michael201110/cryobelt/cryobelt.kicad_pcb

## KiCad design cryobelt.kicad_pcb (2026-08-23)

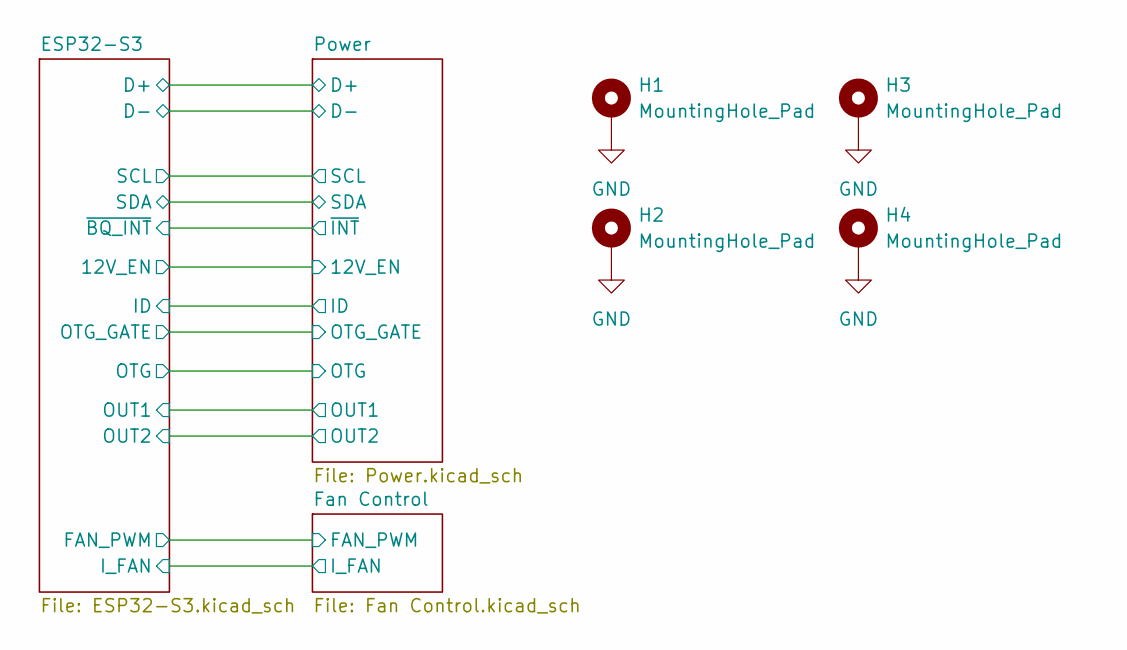
[picture p1: schematic cryobelt.kicad_sch]

Parts:
H1, H2, H3, H4: MountingHole_Pad; MountingHole_2.2mm_M2_Pad_TopBottom

Connections:
GND: H1.1 (1_1), H2.1 (1_1), H3.1 (1_1), H4.1 (1_1); also elsewhere on the board

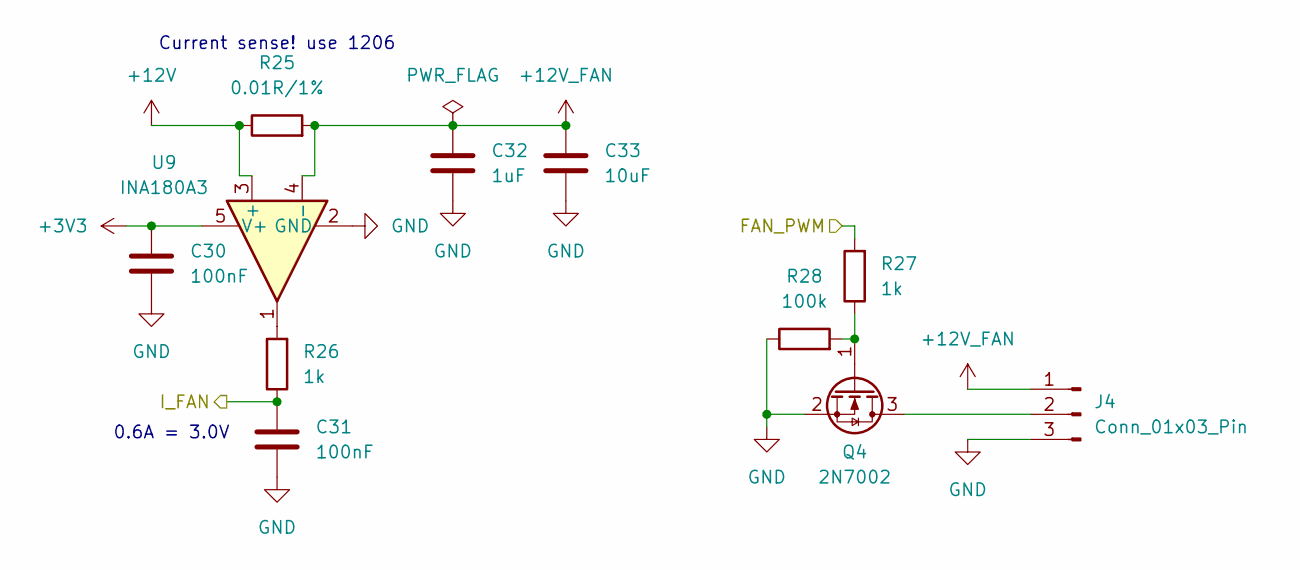
[picture p2: schematic Fan Control.kicad_sch]

Parts:
C30, C31: 100nF; C_0603_1608Metric; MPN CC0603KRX7R9BB104; LCSC Part # C14663
C32: 1uF; C_0603_1608Metric; MPN CL10A105KB8NNNC; LCSC Part # C15849
C33: 10uF; C_0603_1608Metric; MPN CL10A106MA8NRNC; LCSC Part # C96446
J4: Conn_01x03_Pin; JST_GH_SM03B-GHS-TB_1x03-1MP_P1.25mm_Horizontal; MPN SM03B-GHS-TB(LF)(SN); LCSC Part # C514175
Q4: 2N7002; SOT-23; MPN 2N7002; LCSC Part # C8545
R25: 0.01R/1%; R_1206_3216Metric; MPN FRM121WFR010TM; LCSC Part # C7467248
R26, R27: 1k; R_0603_1608Metric; MPN 0603WAF1001T5E; LCSC Part # C21190
R28: 100k; R_0603_1608Metric; MPN 0603WAF1003T5E; LCSC Part # C25803
U9: INA180A3; SOT-23-5; MPN INA180A3IDBVR; LCSC Part # C122882

Connections:
+3V3: C30.1, U9.5 (V+); also elsewhere on the board
+12V: R25.1, U9.3 (+); also elsewhere on the board
+12V_FAN: C32.1, C33.1, J4.1, R25.2, U9.4 (-)
/ESP32-S3/FAN_PWM: R27.2; also elsewhere on the board
/ESP32-S3/I_FAN: C31.1, R26.1; also elsewhere on the board
GND: C30.2, C31.2, C32.2, C33.2, J4.3, Q4.2 (S), R28.1, U9.2 (GND); also elsewhere on the board
unnamed: J4.2, Q4.3 (D)
unnamed: Q4.1 (G), R27.1, R28.2
unnamed: R26.2, U9.1

Notes on the sheet:
0.6A = 3.0V
Current sense! use 1206

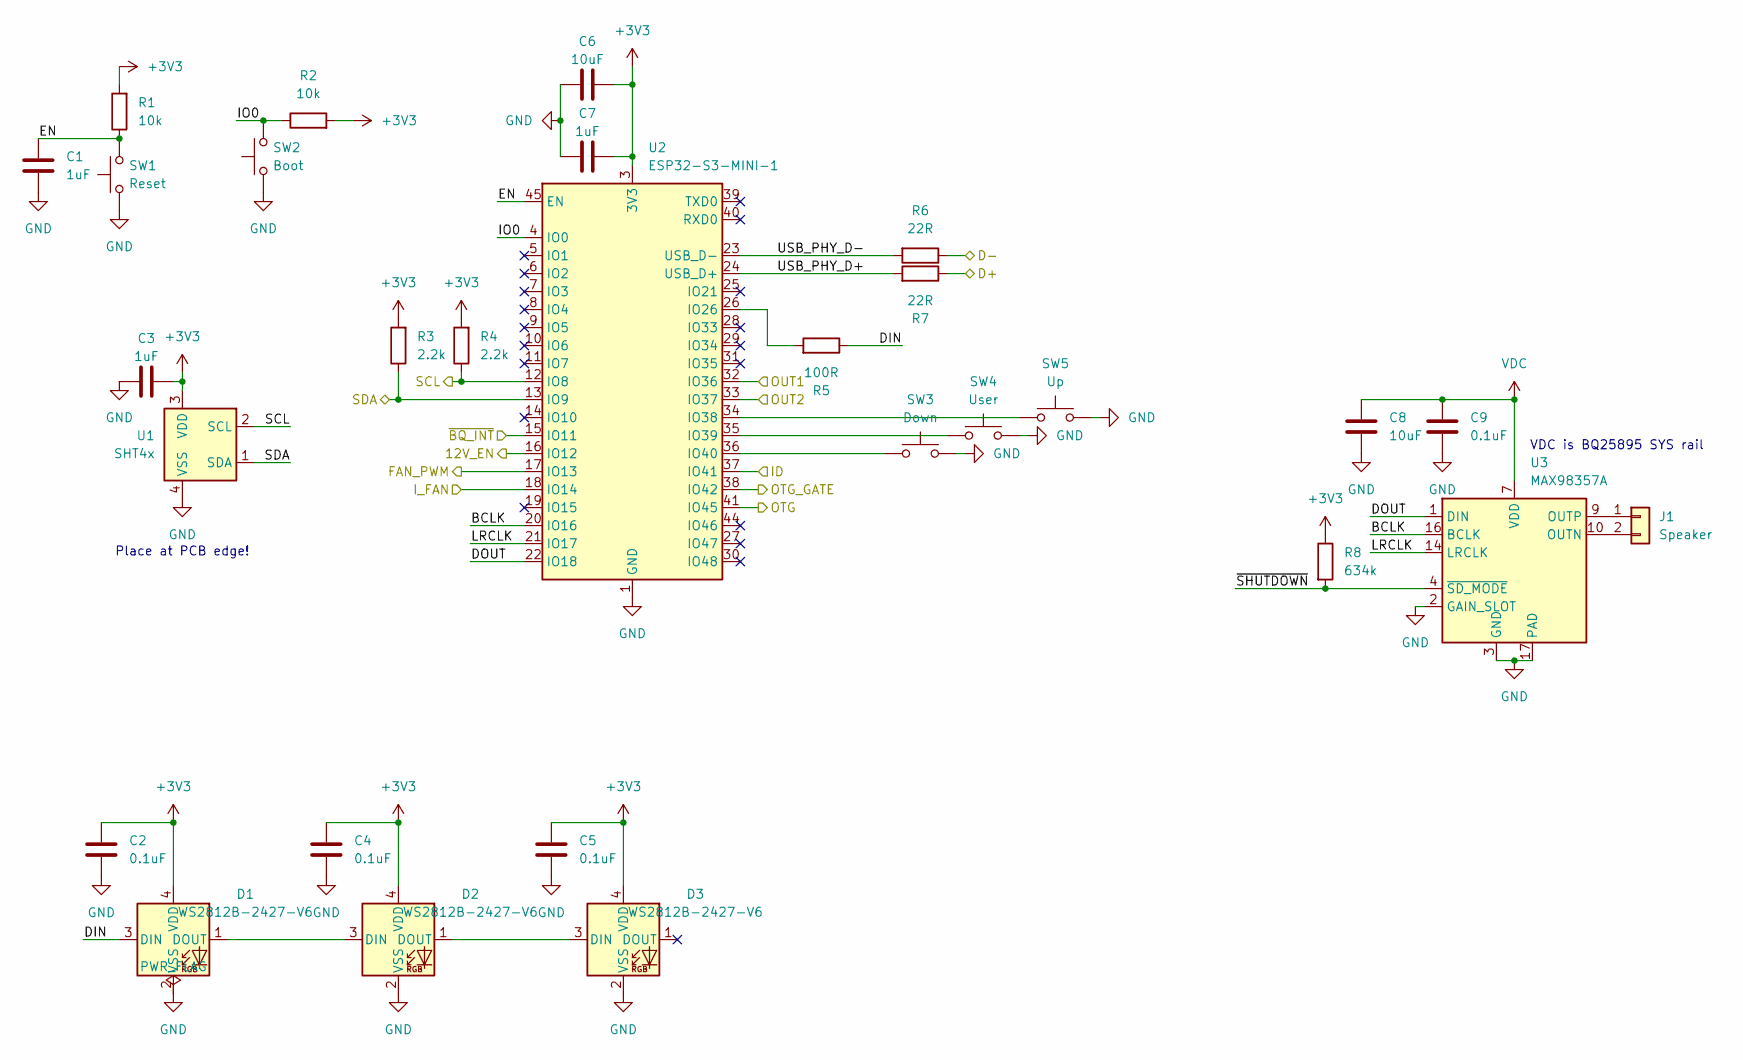
[picture p3: schematic ESP32-S3.kicad_sch]

Parts:
C1, C3, C7: 1uF; C_0603_1608Metric; MPN CL10A105KB8NNNC; LCSC Part # C15849
C2, C4, C5: 0.1uF; C_0402_1005Metric; MPN CL05B104KO5NNNC; LCSC Part # C1525
C6, C8: 10uF; C_0603_1608Metric; MPN CL10A106KP8NNNC; LCSC Part # C19702
C9: 0.1uF; C_0603_1608Metric; MPN CC0603KRX7R9BB104; LCSC Part # C14663
D1, D2, D3: WS2812B-2427-V6; WS2812B-2427-V6_Rotated180; MPN WS2812B-2427-V6; LCSC Part # C52941389
J1: Speaker; SolderWire-0.1sqmm_1x02_P3.6mm_D0.4mm_OD1mm
R1, R2: 10k; R_0603_1608Metric; MPN 0603WAF1002T5E; LCSC Part # C25804
R3, R4: 2.2k; R_0603_1608Metric; MPN 0603WAF2201T5E; LCSC Part # C4190
R5: 100R; R_0603_1608Metric; MPN 0603WAF1000T5E; LCSC Part # C22775
R6, R7: 22R; R_0603_1608Metric; MPN 0603WAF220JT5E; LCSC Part # C23345
R8: 634k; R_0603_1608Metric; MPN RC0603FR-07634KL; LCSC Part # C273753
SW1: Reset; SW_Push_1P1T_XKB_TS-1187A; MPN TS-1187A-B-A-B; LCSC Part # C318884
SW2: Boot; SW_Push_1P1T_XKB_TS-1187A; MPN TS-1187A-B-A-B; LCSC Part # C318884
SW3: Down; PG1316S
SW4: User; PG1316S
SW5: Up; PG1316S
U1: SHT4x; Sensirion_DFN-4_1.5x1.5mm_P0.8mm_SHT4x_NoCentralPad; MPN SHT40-AD1B-R2; LCSC Part # C2909890
U2: ESP32-S3-MINI-1; MPN ESP32-S3-MINI-1-N8; LCSC Part # C2913206
U3: MAX98357A; TQFN-16-1EP_3x3mm_P0.5mm_EP1.23x1.23mm; MPN MAX98357AETE+T; LCSC Part # C910544

Connections:
+3V3: C2.1, C3.2, C4.1, C5.1, C6.2, C7.2, D1.4 (VDD), D2.4 (VDD), D3.4 (VDD), R1.2, R2.2, R3.2, R4.2, R8.1, U1.3 (VDD), U2.3 (3V3); also elsewhere on the board
/ESP32-S3/12V_EN: U2.16 (IO12); also elsewhere on the board
/ESP32-S3/BCLK: U2.20 (IO16), U3.16 (BCLK)
/ESP32-S3/D+: R7.1; also elsewhere on the board
/ESP32-S3/D-: R6.1; also elsewhere on the board
/ESP32-S3/DIN: D1.3 (DIN), R5.1
/ESP32-S3/DOUT: U2.22 (IO18), U3.1 (DIN)
/ESP32-S3/EN: C1.1, R1.1, SW1.2, U2.45 (EN)
/ESP32-S3/FAN_PWM: U2.17 (IO13); also elsewhere on the board
/ESP32-S3/ID: U2.37 (IO41); also elsewhere on the board
/ESP32-S3/IO0: R2.1, SW2.2, U2.4 (IO0)
/ESP32-S3/I_FAN: U2.18 (IO14); also elsewhere on the board
/ESP32-S3/LRCLK: U2.21 (IO17), U3.14 (LRCLK)
/ESP32-S3/OTG: U2.41 (IO45); also elsewhere on the board
/ESP32-S3/OTG_GATE: U2.38 (IO42); also elsewhere on the board
/ESP32-S3/OUT1: U2.32 (IO36); also elsewhere on the board
/ESP32-S3/OUT2: U2.33 (IO37); also elsewhere on the board
/ESP32-S3/SCL: R4.1, U1.2 (SCL), U2.12 (IO8); also elsewhere on the board
/ESP32-S3/SDA: R3.1, U1.1 (SDA), U2.13 (IO9); also elsewhere on the board
/ESP32-S3/USB_PHY_D+: R7.2, U2.24 (USB_D+)
/ESP32-S3/USB_PHY_D-: R6.2, U2.23 (USB_D-)
/ESP32-S3/~BQ_INT: U2.15 (IO11); also elsewhere on the board
/ESP32-S3/~SHUTDOWN: R8.2, U3.4 (~SD_MODE)
GND: C1.2, C2.2, C3.1, C4.2, C5.2, C6.1, C7.1, C8.2, C9.2, D1.2 (VSS), D2.2 (VSS), D3.2 (VSS), SW1.1, SW2.1, SW3.2, SW4.2, SW5.2, U1.4 (VSS), U2.1 (GND), U2.2 (GND), U2.42 (GND), U2.43 (GND), U2.46 (GND), U2.47 (GND), U2.48 (GND), U2.49 (GND), U2.50 (GND), U2.51 (GND), U2.52 (GND), U2.53 (GND), U2.54 (GND), U2.55 (GND), U2.56 (GND), U2.57 (GND), U2.58 (GND), U2.59 (GND), U2.60 (GND), U2.61 (GND), U2.62 (GND), U2.63 (GND), U2.64 (GND), U2.65 (GND), U3.2 (GAIN_SLOT), U3.3 (GND), U3.11 (GND), U3.15 (GND), U3.17 (PAD); also elsewhere on the board
unnamed: D1.1 (DOUT), D2.3 (DIN)
unnamed: D2.1 (DOUT), D3.3 (DIN)
unnamed: J1.1, U3.9 (OUTP)
unnamed: J1.2, U3.10 (OUTN)
unnamed: R5.2, U2.26 (IO26)
unnamed: SW5.1, U2.34 (IO38)
unnamed: SW4.1, U2.35 (IO39)
unnamed: SW3.1, U2.36 (IO40)
VDC: C8.1, C9.1, U3.7 (VDD), U3.8 (VDD); also elsewhere on the board

Notes on the sheet:
VDC is BQ25895 SYS rail
Place at PCB edge!

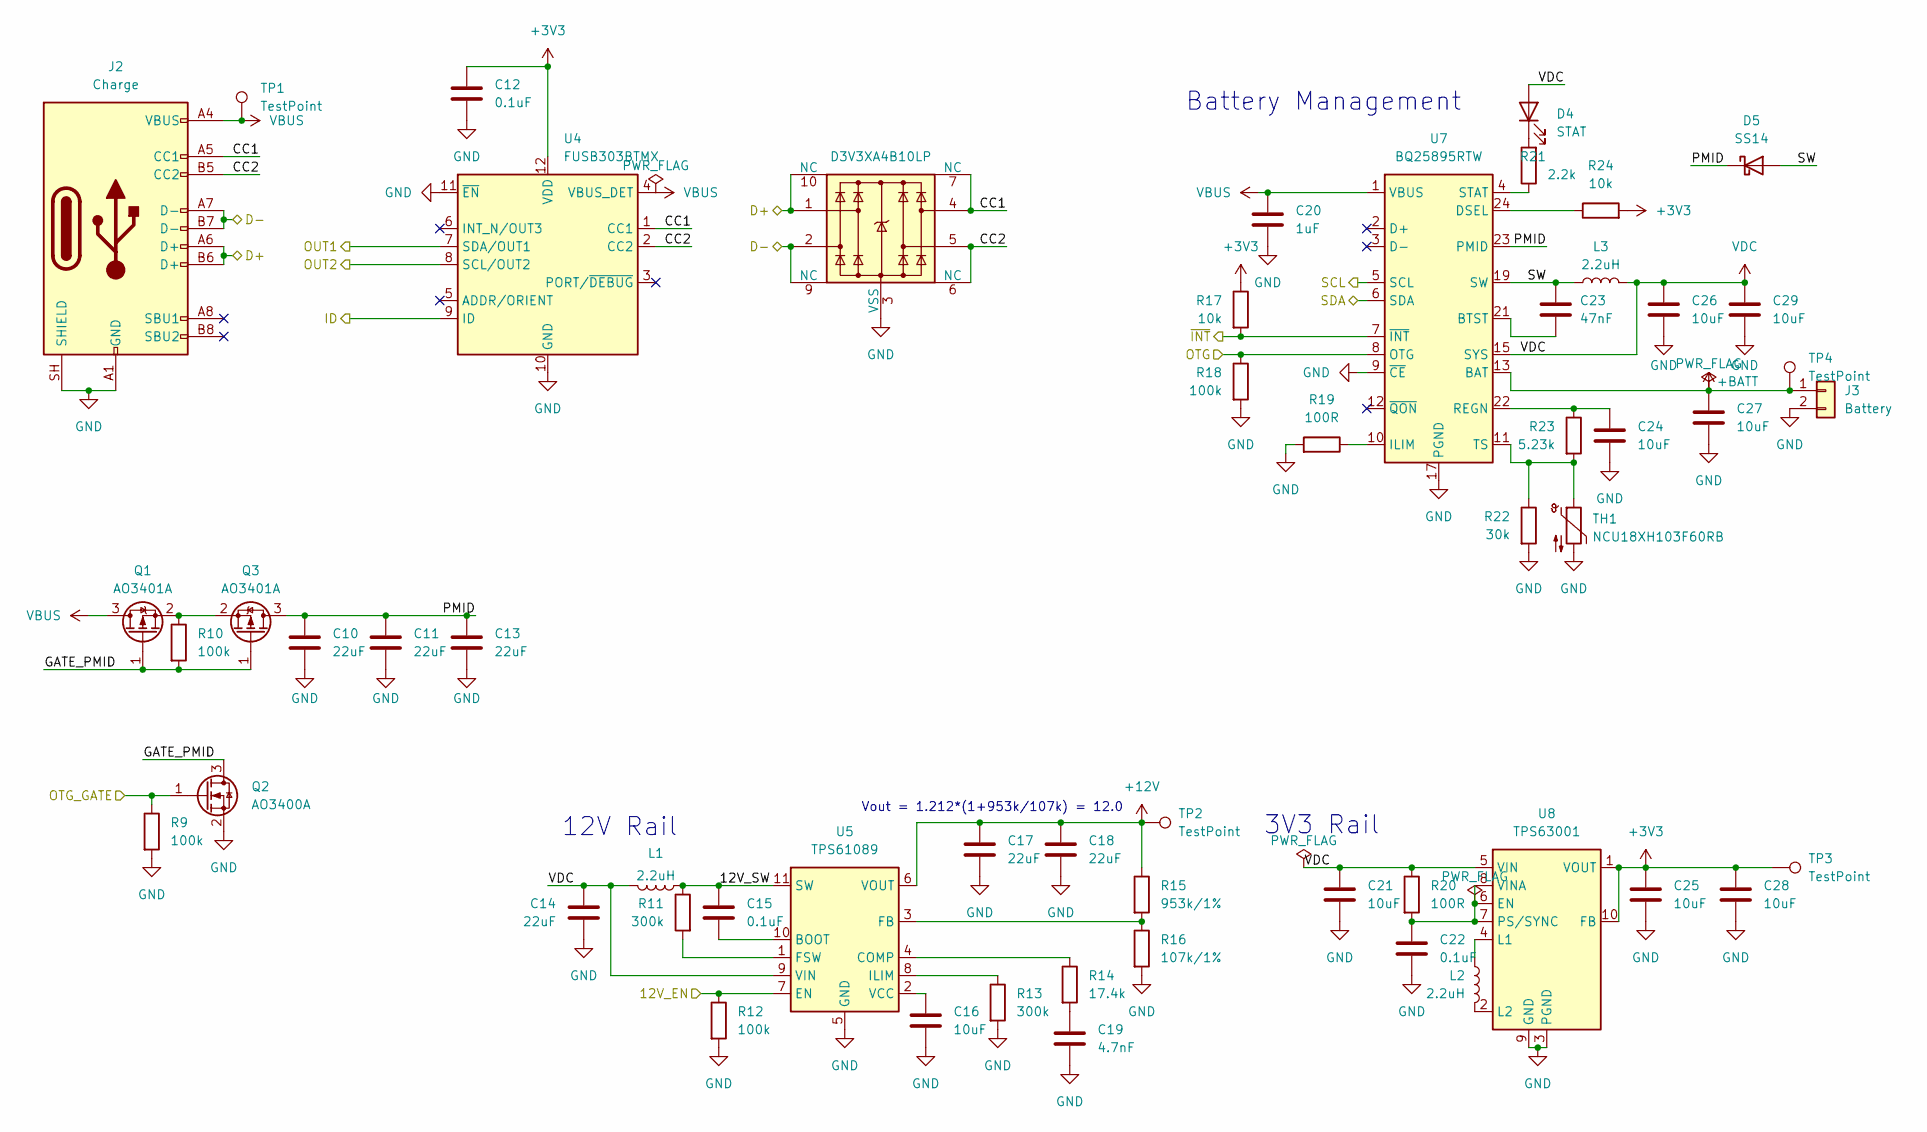
[picture p4: schematic Power.kicad_sch]

Parts:
C10, C11, C13, C17, C18: 22uF; C_0805_2012Metric; MPN CL21A226MAQNNNE; LCSC Part # C45783
C12, C15, C22: 0.1uF; C_0603_1608Metric; MPN CC0603KRX7R9BB104; LCSC Part # C14663
C14: 22uF; C_0603_1608Metric; MPN CL10A226MQ8NRNC; LCSC Part # C59461
C16, C21, C24, C25, C26, C27, C28, C29: 10uF; C_0603_1608Metric; MPN CL10A106KP8NNNC; LCSC Part # C19702
C19: 4.7nF; C_0603_1608Metric; MPN 0603B472K500NT; LCSC Part # C53987
C20: 1uF; C_0603_1608Metric; MPN CL10A105KB8NNNC; LCSC Part # C15849
C23: 47nF; C_0603_1608Metric; MPN CL10B473KB8NNNC; LCSC Part # C1622
D4: STAT; LED_0603_1608Metric; MPN KT-0603R; LCSC Part # C2286
D5: SS14; D_SMA; MPN SS14; LCSC Part # C2480
J2: Charge; USB_C_Receptacle_GCT_USB4110; MPN USB4110-GF-A; LCSC Part # C5143397
J3: Battery; JST_PH_S2B-PH-K_1x02_P2.00mm_Horizontal; MPN S2B-PH-K-S(LF)(SN); LCSC Part # C173752
L1, L2, L3: 2.2uH; L_Changjiang_FNR4030S; MPN FEXU0420S2R2MBS; LCSC Part # C54777963
Q1, Q3: AO3401A; SOT-23; MPN AO3401A; LCSC Part # C15127
Q2: AO3400A; SOT-23; MPN AO3400A; LCSC Part # C20917
R9, R10, R12, R18: 100k; R_0603_1608Metric; MPN 0603WAF1003T5E; LCSC Part # C25803
R11, R13: 300k; R_0603_1608Metric; MPN 0603WAF3003T5E; LCSC Part # C23024
R14: 17.4k; R_0603_1608Metric; MPN RC0603FR-0717K4L; LCSC Part # C185365
R15: 953k/1%; R_0603_1608Metric; MPN ERJ3EKF9533V; LCSC Part # C403405
R16: 107k/1%; R_0603_1608Metric; MPN RC0603FR-07107KL; LCSC Part # C245894
R17, R24: 10k; R_0603_1608Metric; MPN 0603WAF1002T5E; LCSC Part # C25804
R19, R20: 100R; R_0603_1608Metric; MPN 0603WAF1000T5E; LCSC Part # C22775
R21: 2.2k; R_0603_1608Metric; MPN 0603WAF2201T5E; LCSC Part # C4190
R22: 30k; R_0603_1608Metric; MPN 0603WAF3002T5E; LCSC Part # C22984
R23: 5.23k; R_0603_1608Metric; MPN RC0603FR-075K23L; LCSC Part # C185317
TH1: NCU18XH103F60RB; R_0603_1608Metric; MPN NCU18XH103F60RB; LCSC Part # C440252
TP1, TP2, TP3, TP4: TestPoint; TestPoint_Pad_D2.0mm
U4: FUSB303BTMX; Texas_X2QFN-12_1.6x1.6mm_P0.4mm; MPN FUSB303BTMX; LCSC Part # C895444
U5: TPS61089; Texas_VQFN-RNR0011A-11; MPN TPS61089RNRR; LCSC Part # C165129
U6: D3V3XA4B10LP; Diodes_UDFN-10_1x2.5mm_P0.5mm; MPN D3V3XA4B10LP-7; LCSC Part # C1980462
U7: BQ25895RTW; Texas_RTW_WQFN-24-1EP_4x4mm_P0.5mm_EP2.7x2.7mm_ThermalVias; MPN BQ25895RTWR; LCSC Part # C80200
U8: TPS63001; Texas_DRC0010J_ThermalVias; MPN TPS63001DRCR; LCSC Part # C28060

Connections:
+3V3: C12.1, C25.1, C28.1, R17.1, R24.2, TP3.1 (1_1), U4.12 (VDD), U8.1 (VOUT), U8.10 (FB); also elsewhere on the board
+12V: C17.1, C18.1, R15.1, TP2.1 (1_1), U5.6 (VOUT); also elsewhere on the board
+BATT: C27.1, J3.1, TP4.1 (1_1), U7.13 (BAT), U7.14 (BAT)
/ESP32-S3/12V_EN: R12.1, U5.7 (EN); also elsewhere on the board
/ESP32-S3/D+: J2.A6 (D+), J2.B6 (D+), U6.1, U6.10 (NC); also elsewhere on the board
/ESP32-S3/D-: J2.A7 (D-), J2.B7 (D-), U6.2, U6.9 (NC); also elsewhere on the board
/ESP32-S3/ID: U4.9 (ID); also elsewhere on the board
/ESP32-S3/OTG: R18.1, U7.8 (OTG); also elsewhere on the board
/ESP32-S3/OTG_GATE: Q2.1 (G), R9.1; also elsewhere on the board
/ESP32-S3/OUT1: U4.7 (SDA/OUT1); also elsewhere on the board
/ESP32-S3/OUT2: U4.8 (SCL/OUT2); also elsewhere on the board
/ESP32-S3/SCL: U7.5 (SCL); also elsewhere on the board
/ESP32-S3/SDA: U7.6 (SDA); also elsewhere on the board
/ESP32-S3/~BQ_INT: R17.2, U7.7 (~INT); also elsewhere on the board
/Power/12V_SW: C15.1, L1.2, R11.1, U5.11 (SW)
/Power/CC1: J2.A5 (CC1), U4.1 (CC1), U6.4, U6.7 (NC)
/Power/CC2: J2.B5 (CC2), U4.2 (CC2), U6.5, U6.6 (NC)
/Power/GATE_PMID: Q1.1 (G), Q2.3 (D), Q3.1 (G), R10.2
/Power/PMID: C10.1, C11.1, C13.1, D5.1 (K), Q3.3 (D), U7.23 (PMID)
/Power/SW: C23.1, D5.2 (A), L3.1, U7.19 (SW), U7.20 (SW)
GND: C10.2, C11.2, C12.2, C13.2, C14.2, C16.2, C17.2, C18.2, C19.2, C20.2, C21.2, C22.2, C24.2, C25.2, C26.2, C27.2, C28.2, C29.2, J2.A1 (GND), J2.A12 (GND), J2.B1 (GND), J2.B12 (GND), J2.SH (SHIELD), J3.2, Q2.2 (S), R9.2, R12.2, R13.2, R16.2, R18.2, R19.2, R22.2, TH1.2, U4.10 (GND), U4.11 (~EN), U5.5 (GND), U6.3 (VSS), U6.8 (VSS), U7.9 (~CE), U7.17 (PGND), U7.18 (PGND), U7.25 (PGND), U8.3 (PGND), U8.9 (GND), U8.11 (PGND); also elsewhere on the board
unnamed: C19.1, R14.2
unnamed: D4.1 (K), R21.2
unnamed: Q1.2 (S), Q3.2 (S), R10.1
unnamed: C15.2, U5.10 (BOOT)
unnamed: R14.1, U5.4 (COMP)
unnamed: R15.2, R16.1, U5.3 (FB)
unnamed: R11.2, U5.1 (FSW)
unnamed: R13.1, U5.8 (ILIM)
unnamed: C16.1, U5.2 (VCC)
unnamed: C23.2, U7.21 (BTST)
unnamed: R24.1, U7.24 (DSEL)
unnamed: R19.1, U7.10 (ILIM)
unnamed: C24.1, R23.1, U7.22 (REGN)
unnamed: R21.1, U7.4 (STAT)
unnamed: R22.1, R23.2, TH1.1, U7.11 (TS)
unnamed: C22.1, R20.2, U8.6 (EN), U8.7 (PS/SYNC), U8.8 (VINA)
unnamed: L2.2, U8.4 (L1)
unnamed: L2.1, U8.2 (L2)
VBUS: C20.1, J2.A4 (VBUS), J2.A9 (VBUS), J2.B4 (VBUS), J2.B9 (VBUS), Q1.3 (D), TP1.1 (1_1), U4.4 (VBUS_DET), U7.1 (VBUS)
VDC: C14.1, C21.1, C26.1, C29.1, D4.2 (A), L1.1, L3.2, R20.1, U5.9 (VIN), U7.15 (SYS), U7.16 (SYS), U8.5 (VIN); also elsewhere on the board

Notes on the sheet:
12V Rail
Battery Management
Vout = 1.212*(1+953k/107k) = 12.0
3V3 Rail

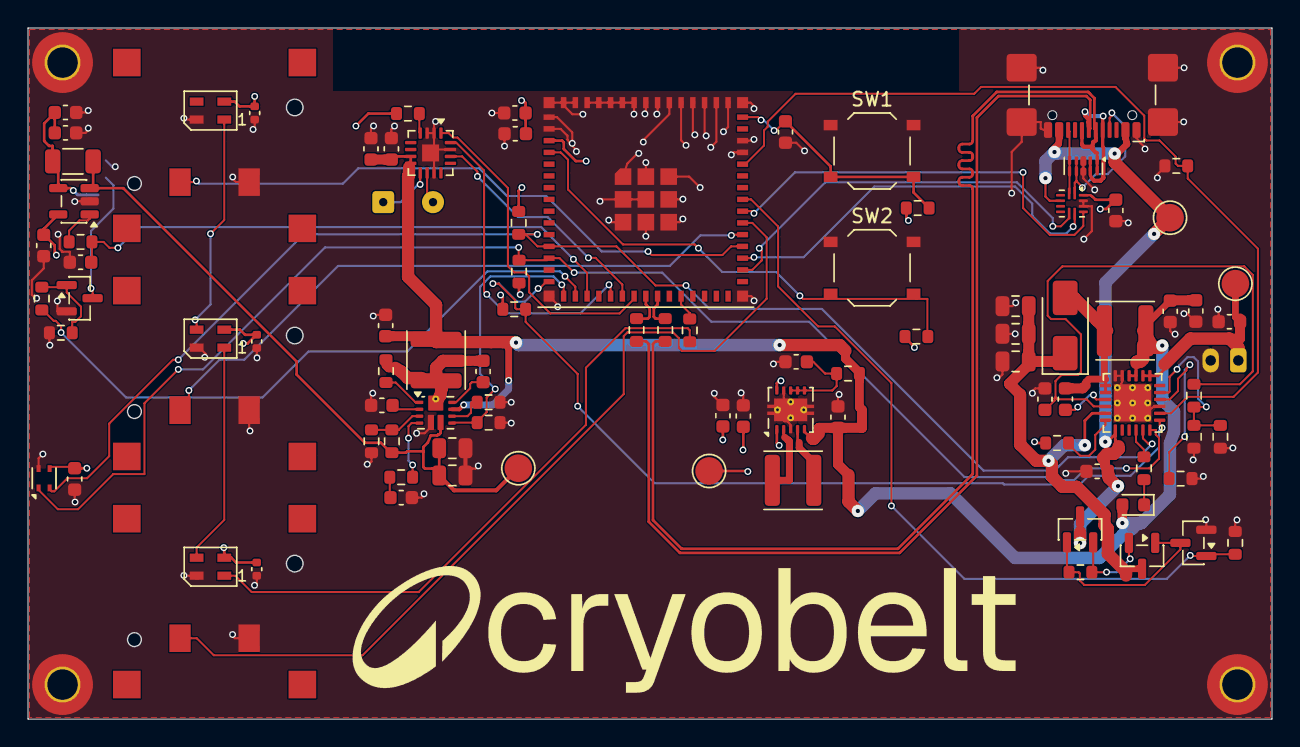
[picture p5: board cryobelt.kicad_pcb from above]

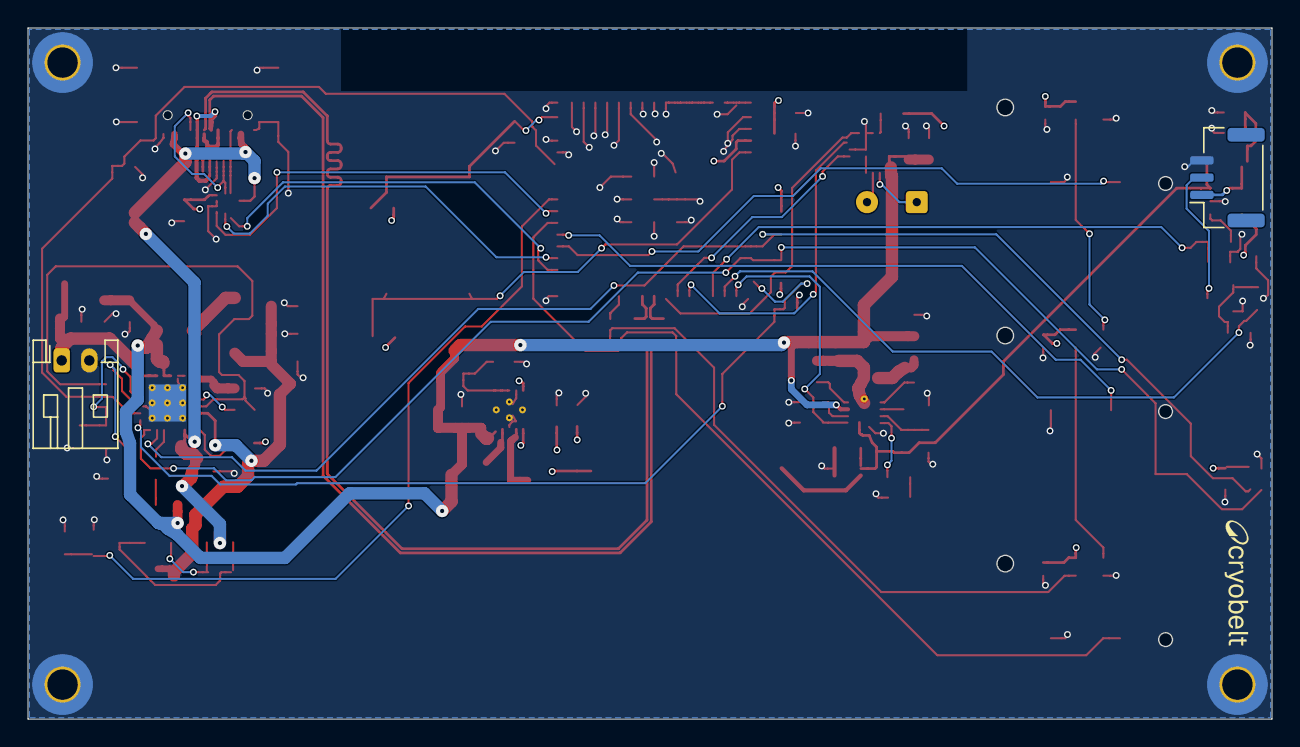
[picture p6: board cryobelt.kicad_pcb from below]

Board: 4 copper layers, 90.0 x 50.0 mm, 100 parts (2 on the bottom side), 64 nets.
