michael201110/cryobelt/(commit log)

2026-07-22 Reset PCB
    [Fan Control.kicad_sch, Power.kicad_sch, cryobelt.kicad_pcb]
2026-07-23 Group power components
    [ESP32-S3.kicad_sch, Power.kicad_sch, cryobelt.kicad_pcb]
2026-07-23 Fully routed, no DRC errors
    tysm Kevin :D
    [ESP32-S3.kicad_sch, Fan Control.kicad_sch, Power.kicad_sch, cryobelt.kicad_pcb]
2026-07-23 Added 3D model
    [bom.csv, cryobelt.csv, cryobelt.kicad_pcb, designators.csv, positions.csv]
2026-07-24 Update 3D model
    [cryobelt.kicad_pcb]
2026-07-27 convert to through vias
    JLCPCB
    [Power.kicad_sch, bom.csv, cryobelt.kicad_pcb]
2026-08-09 Fixed DOUT short circuit
    [ESP32-S3.kicad_sch, cryobelt.kicad_pcb]
2026-08-13 BQ fixes
    i hate my life
    [Fan Control.kicad_sch, Power.kicad_sch, bom.csv, cryobelt.kicad_pcb, designators.csv, positions.csv]
2026-08-13 Fix more bugs
    [ESP32-S3.kicad_sch, Fan Control.kicad_sch, Power.kicad_sch, bom.csv, cryobelt.kicad_pcb, cryobelt.kicad_sch, designators.csv, positions.csv]
2026-08-14 Finalize routed Cryobelt PCB for fabrication
    [ESP32-S3.kicad_sch, Fan Control.kicad_sch, Power.kicad_sch, bom.csv, cryobelt.csv, cryobelt.kicad_pcb, cryobelt.kicad_sch, jlcpcb_bom.csv]
2026-08-14 Resolve R15 and R25 assembly sourcing
    [Fan Control.kicad_sch, Power.kicad_sch, bom.csv, cryobelt.csv, cryobelt.kicad_pcb, jlcpcb_bom.csv, jlcpcb_sourcing.csv]
2026-08-14 Replace SK6805 LEDs with 3.3V WS2812B
    [ESP32-S3.kicad_sch, cryobelt.kicad_pcb, jlcpcb_bom.csv, jlcpcb_sourcing.csv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]
2026-08-14 Update production files
    [bom.csv, cryobelt.kicad_pcb]
2026-08-14 Correct charger bootstrap and audio mode values
    [ESP32-S3.kicad_sch, Power.kicad_sch, bom.csv, cryobelt.csv, cryobelt.kicad_pcb, jlcpcb_bom.csv, jlcpcb_sourcing.csv]
2026-08-16 Optimise BOM
    [ESP32-S3.kicad_sch, Fan Control.kicad_sch, Power.kicad_sch, bom.csv, cryobelt.kicad_pcb, jlcpcb_bom.csv, jlcpcb_sourcing.csv]
2026-08-17 Optimize Cryobelt JLC assembly parts
    [ESP32-S3.kicad_sch, Fan Control.kicad_sch, Power.kicad_sch, bom.csv, cryobelt.csv, cryobelt.kicad_pcb, jlcpcb_bom.csv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]
2026-08-23 Final v2
    [bom.csv, cryobelt.kicad_pcb]
